fuyualice/Home_Temperature_Monitor/Hardware/M1A4/Preview/PCB.pdf

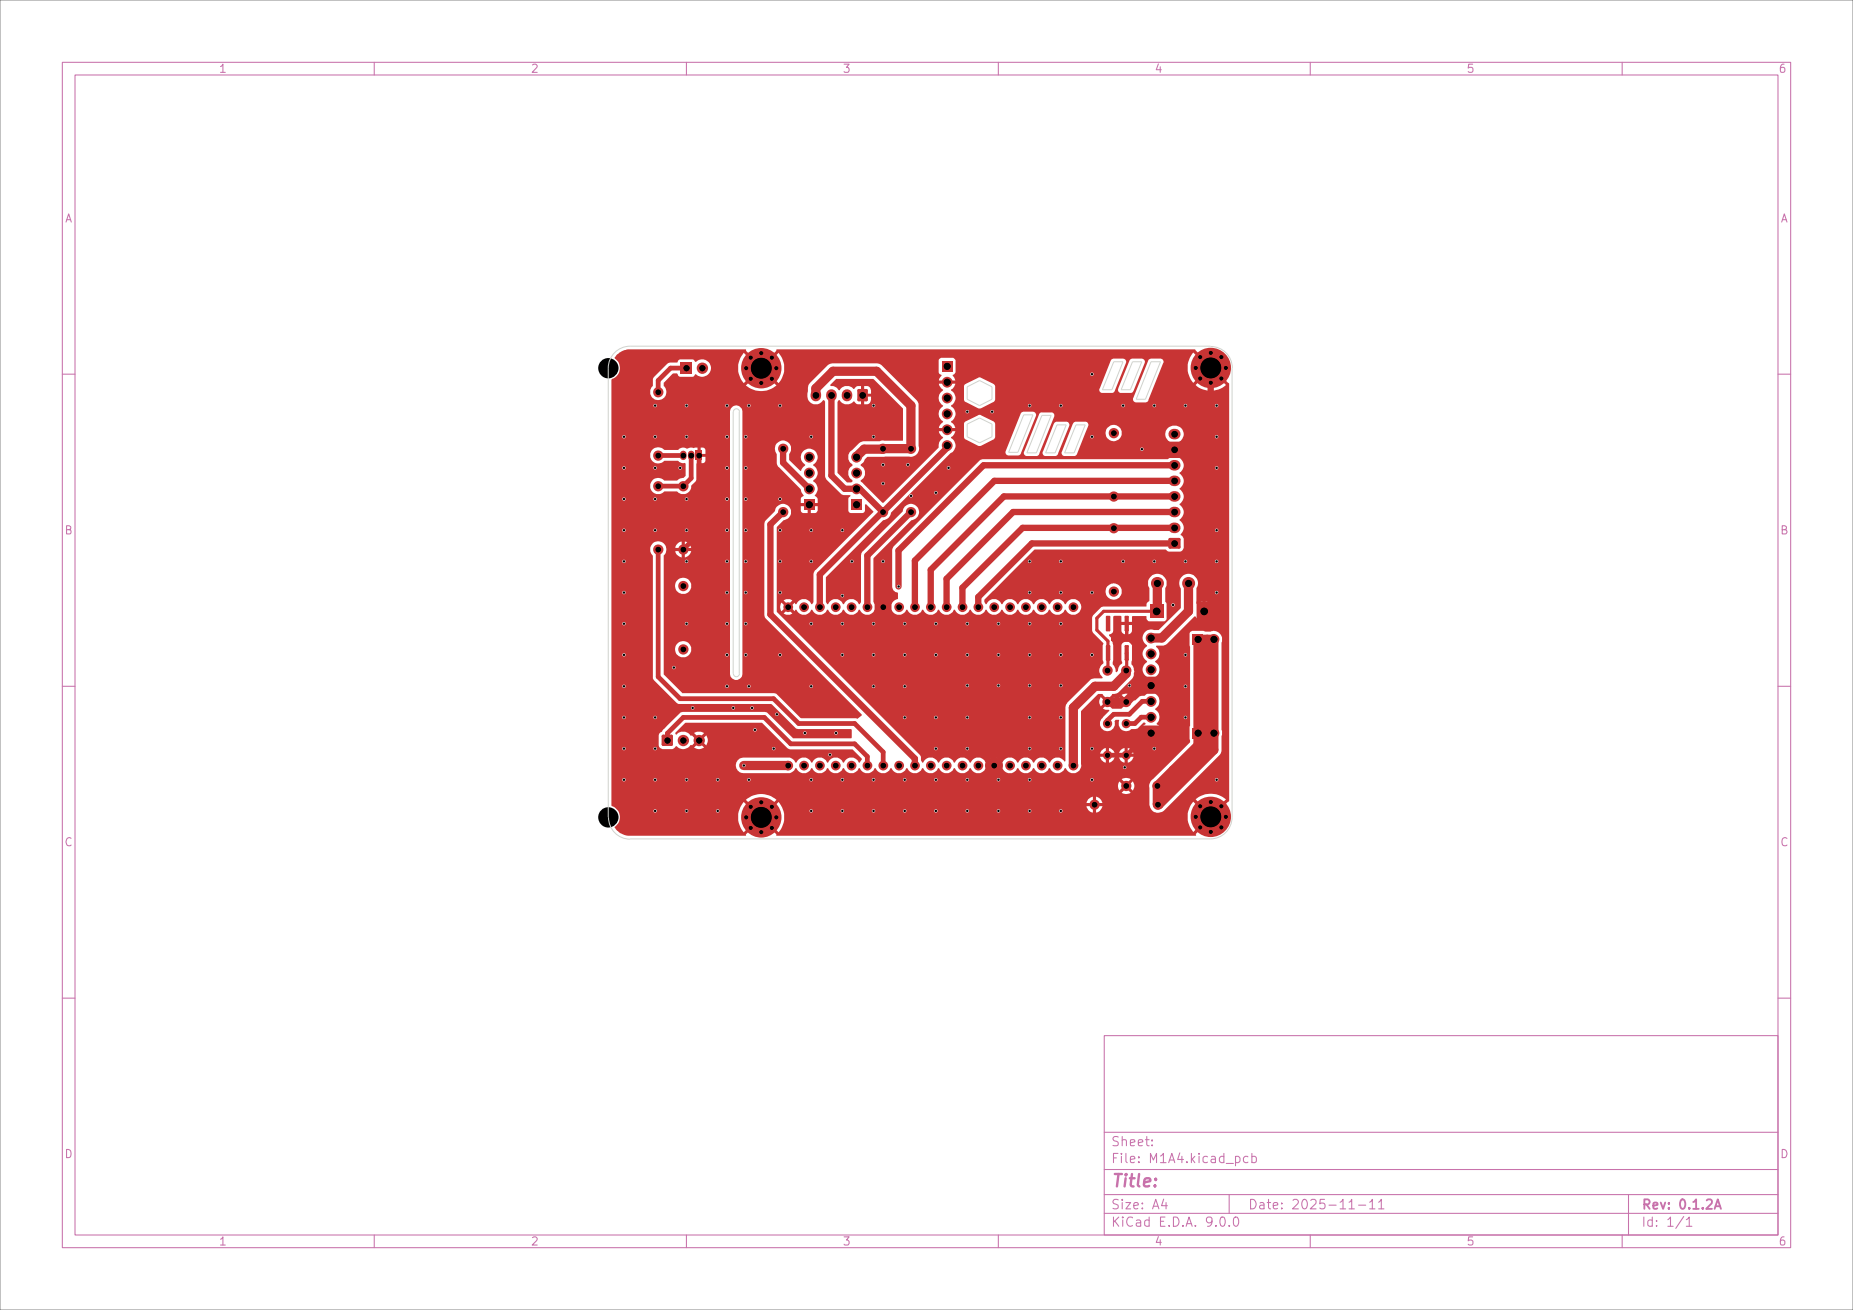
[picture p1: page 1]

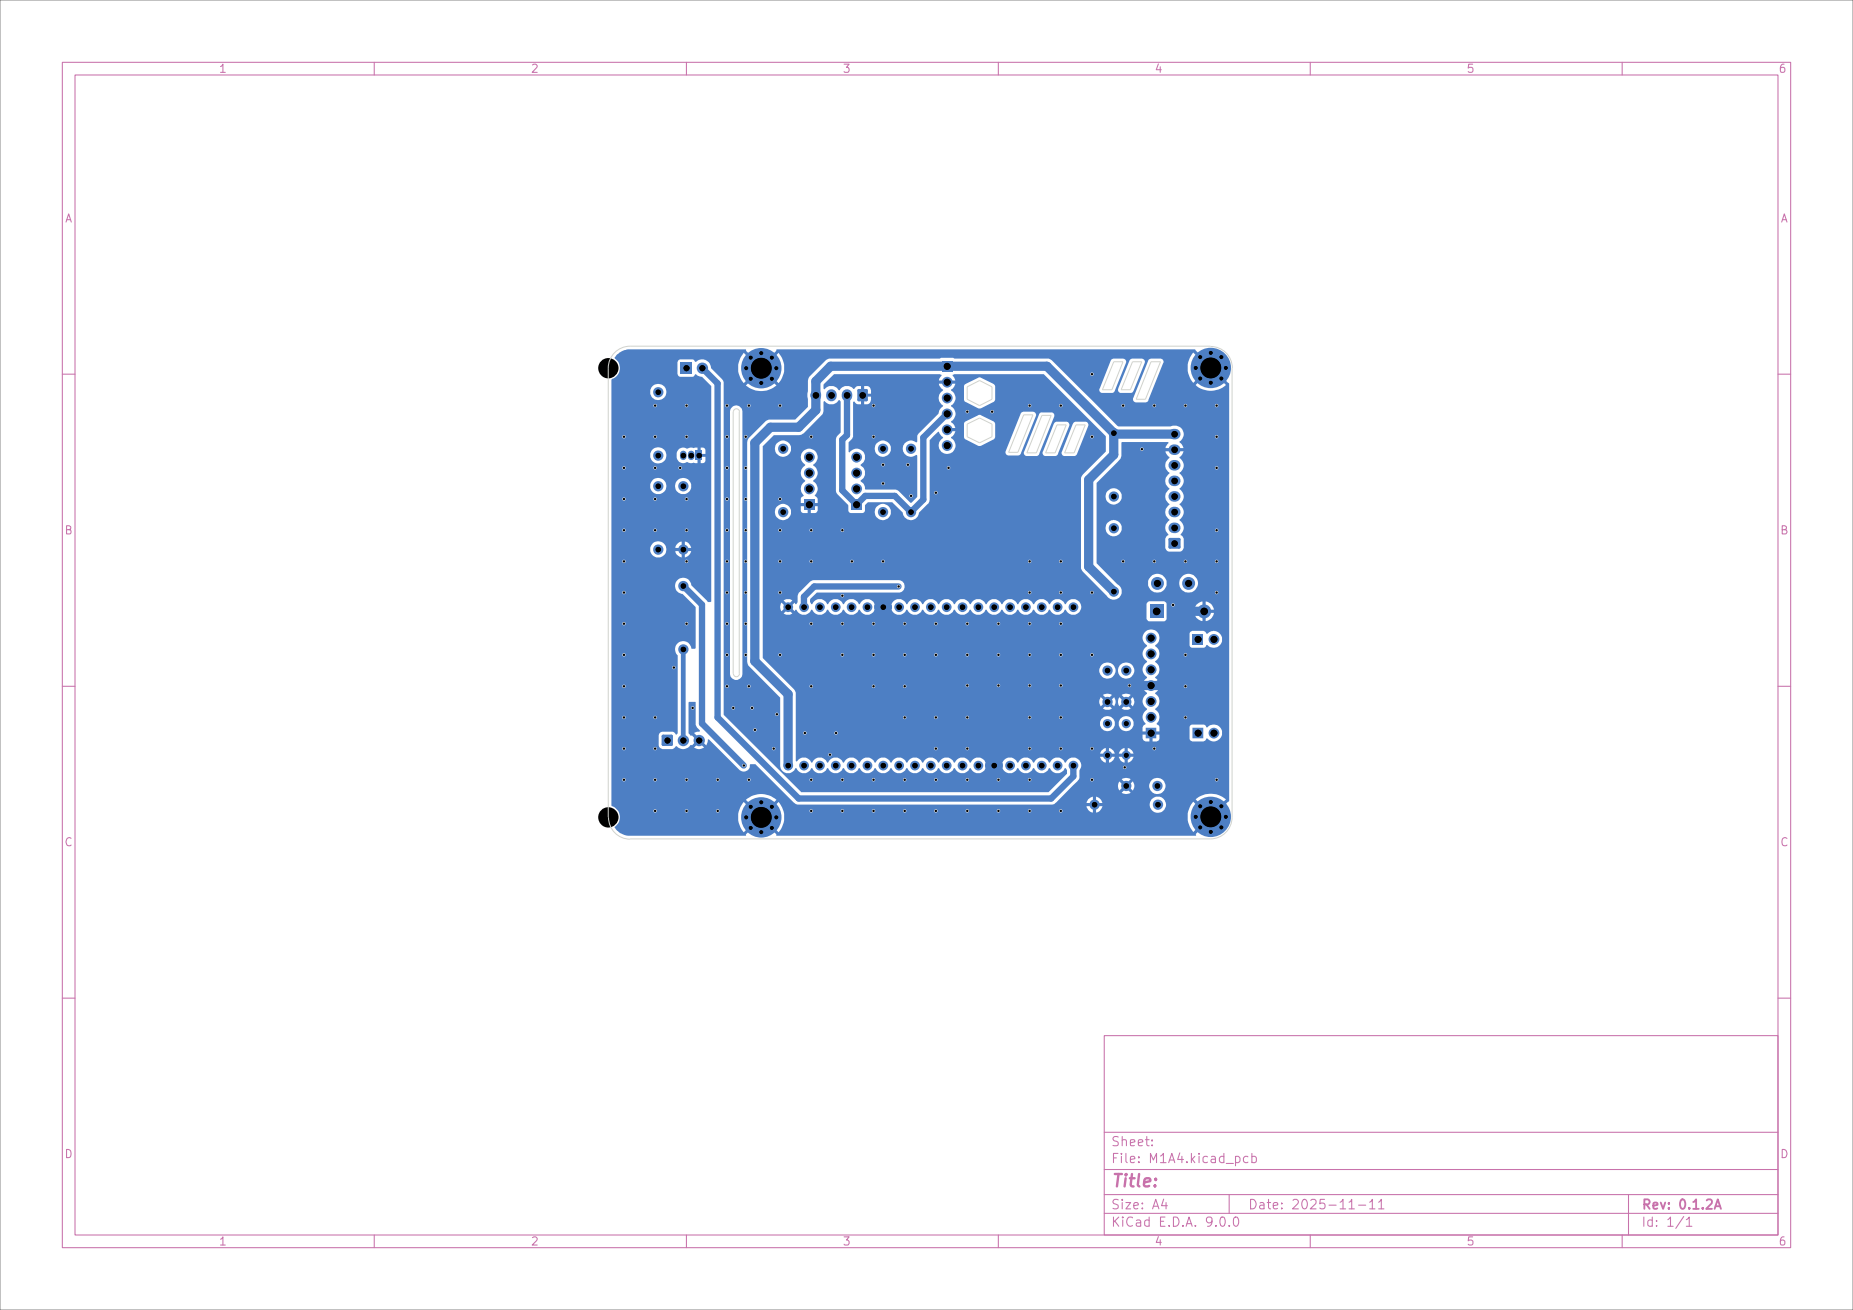
[picture p2: page 2]

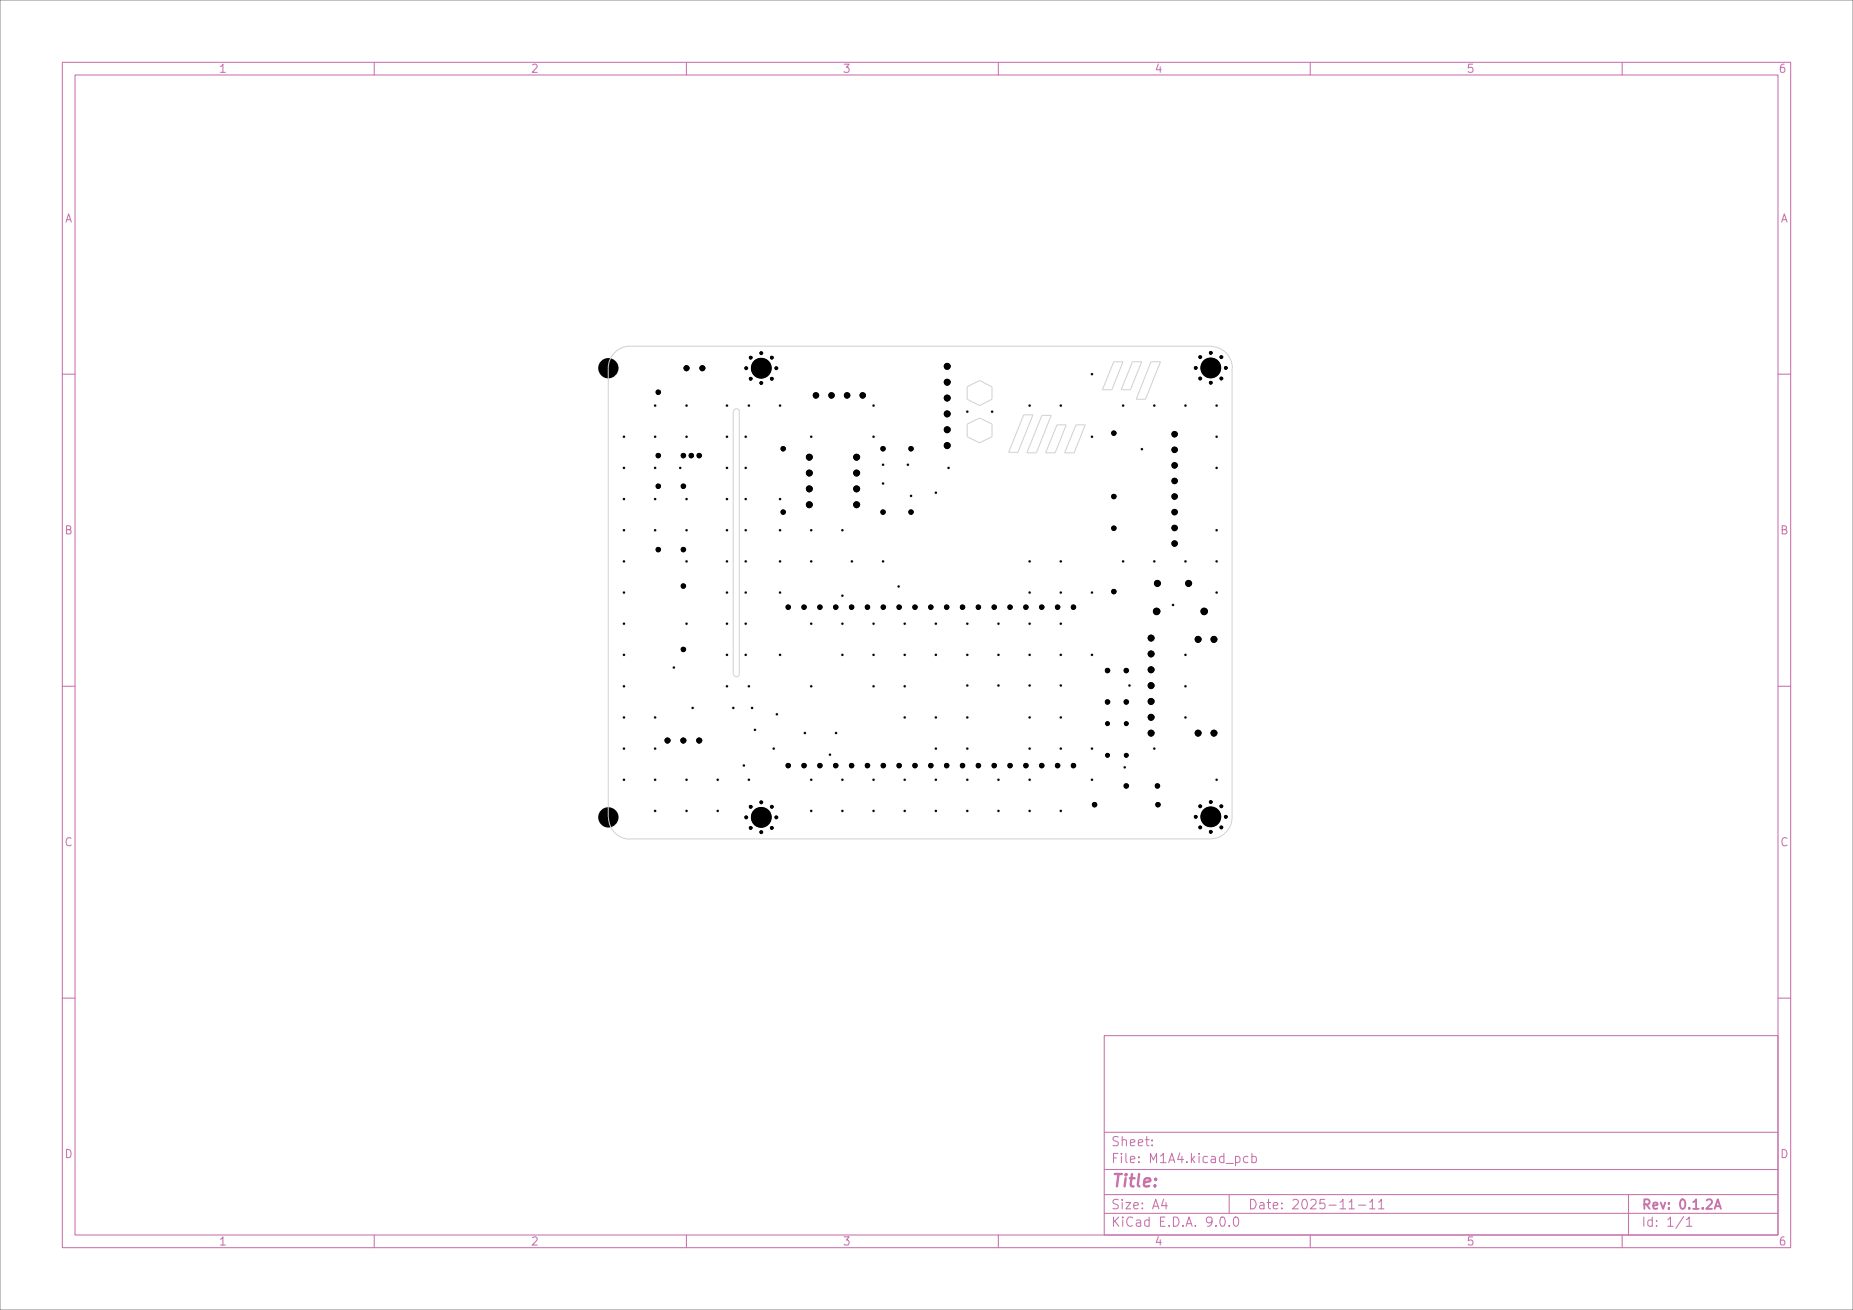
[picture p3: page 3]

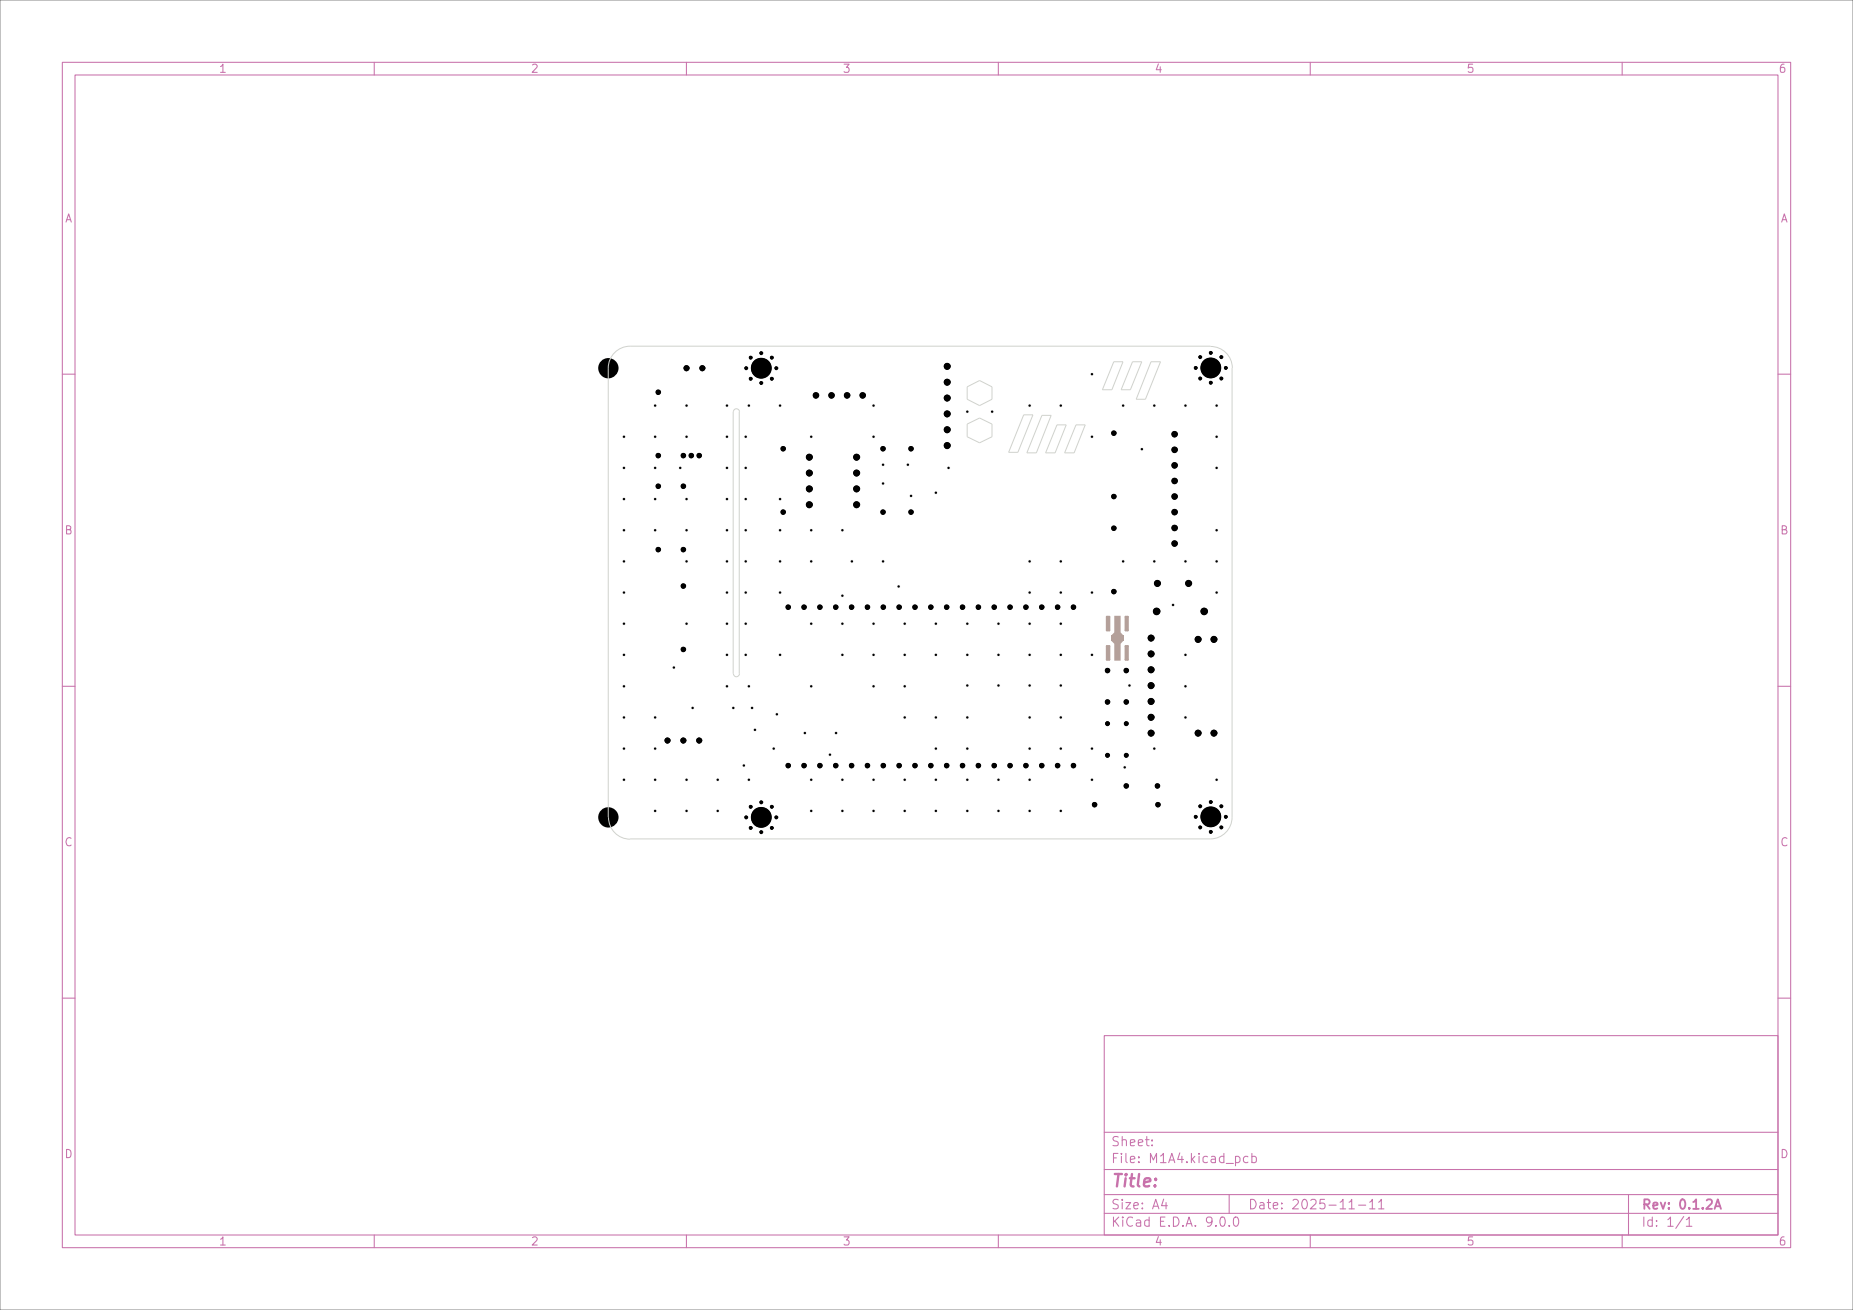
[picture p4: page 5]

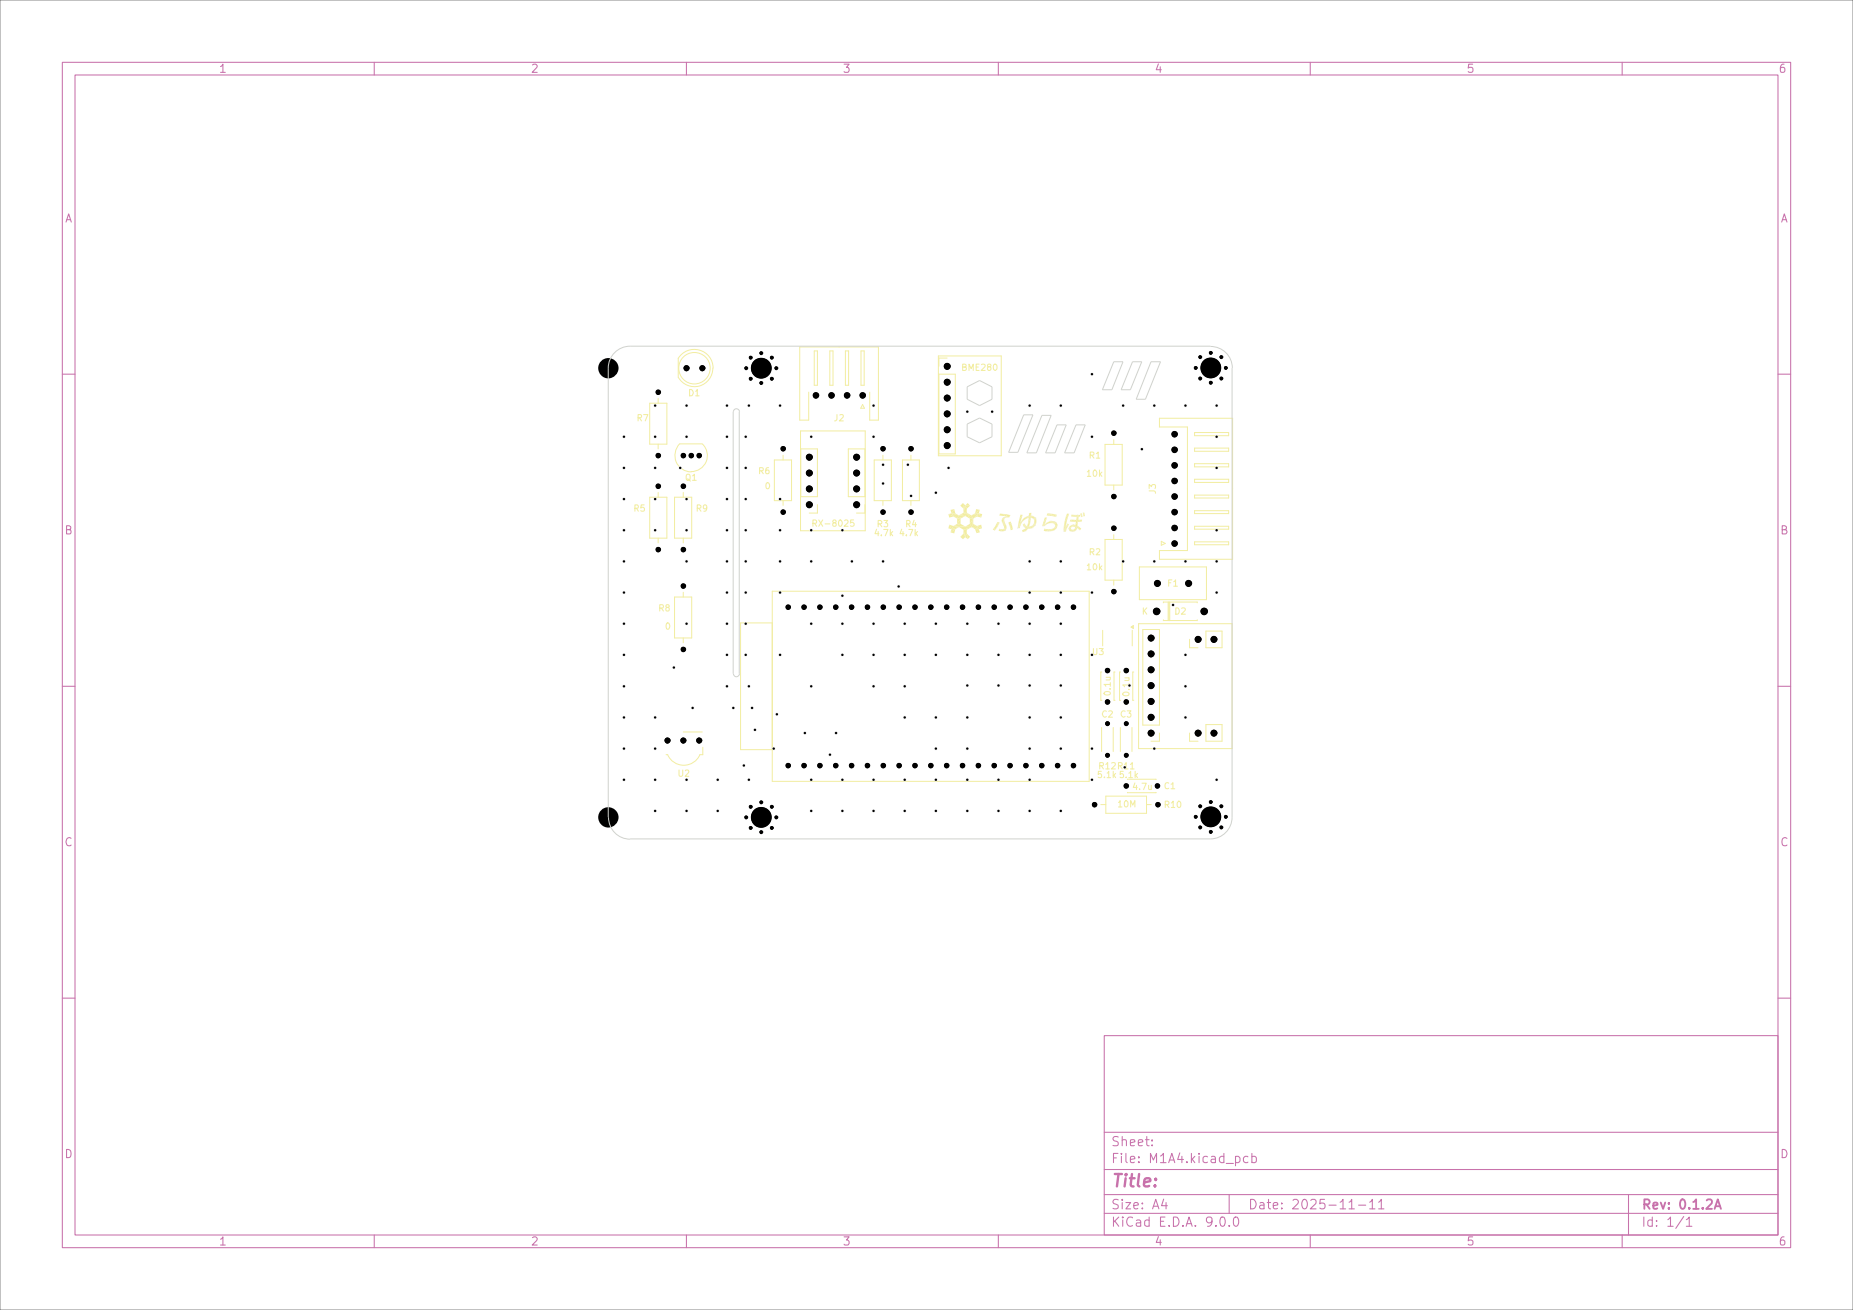
[picture p5: page 7]

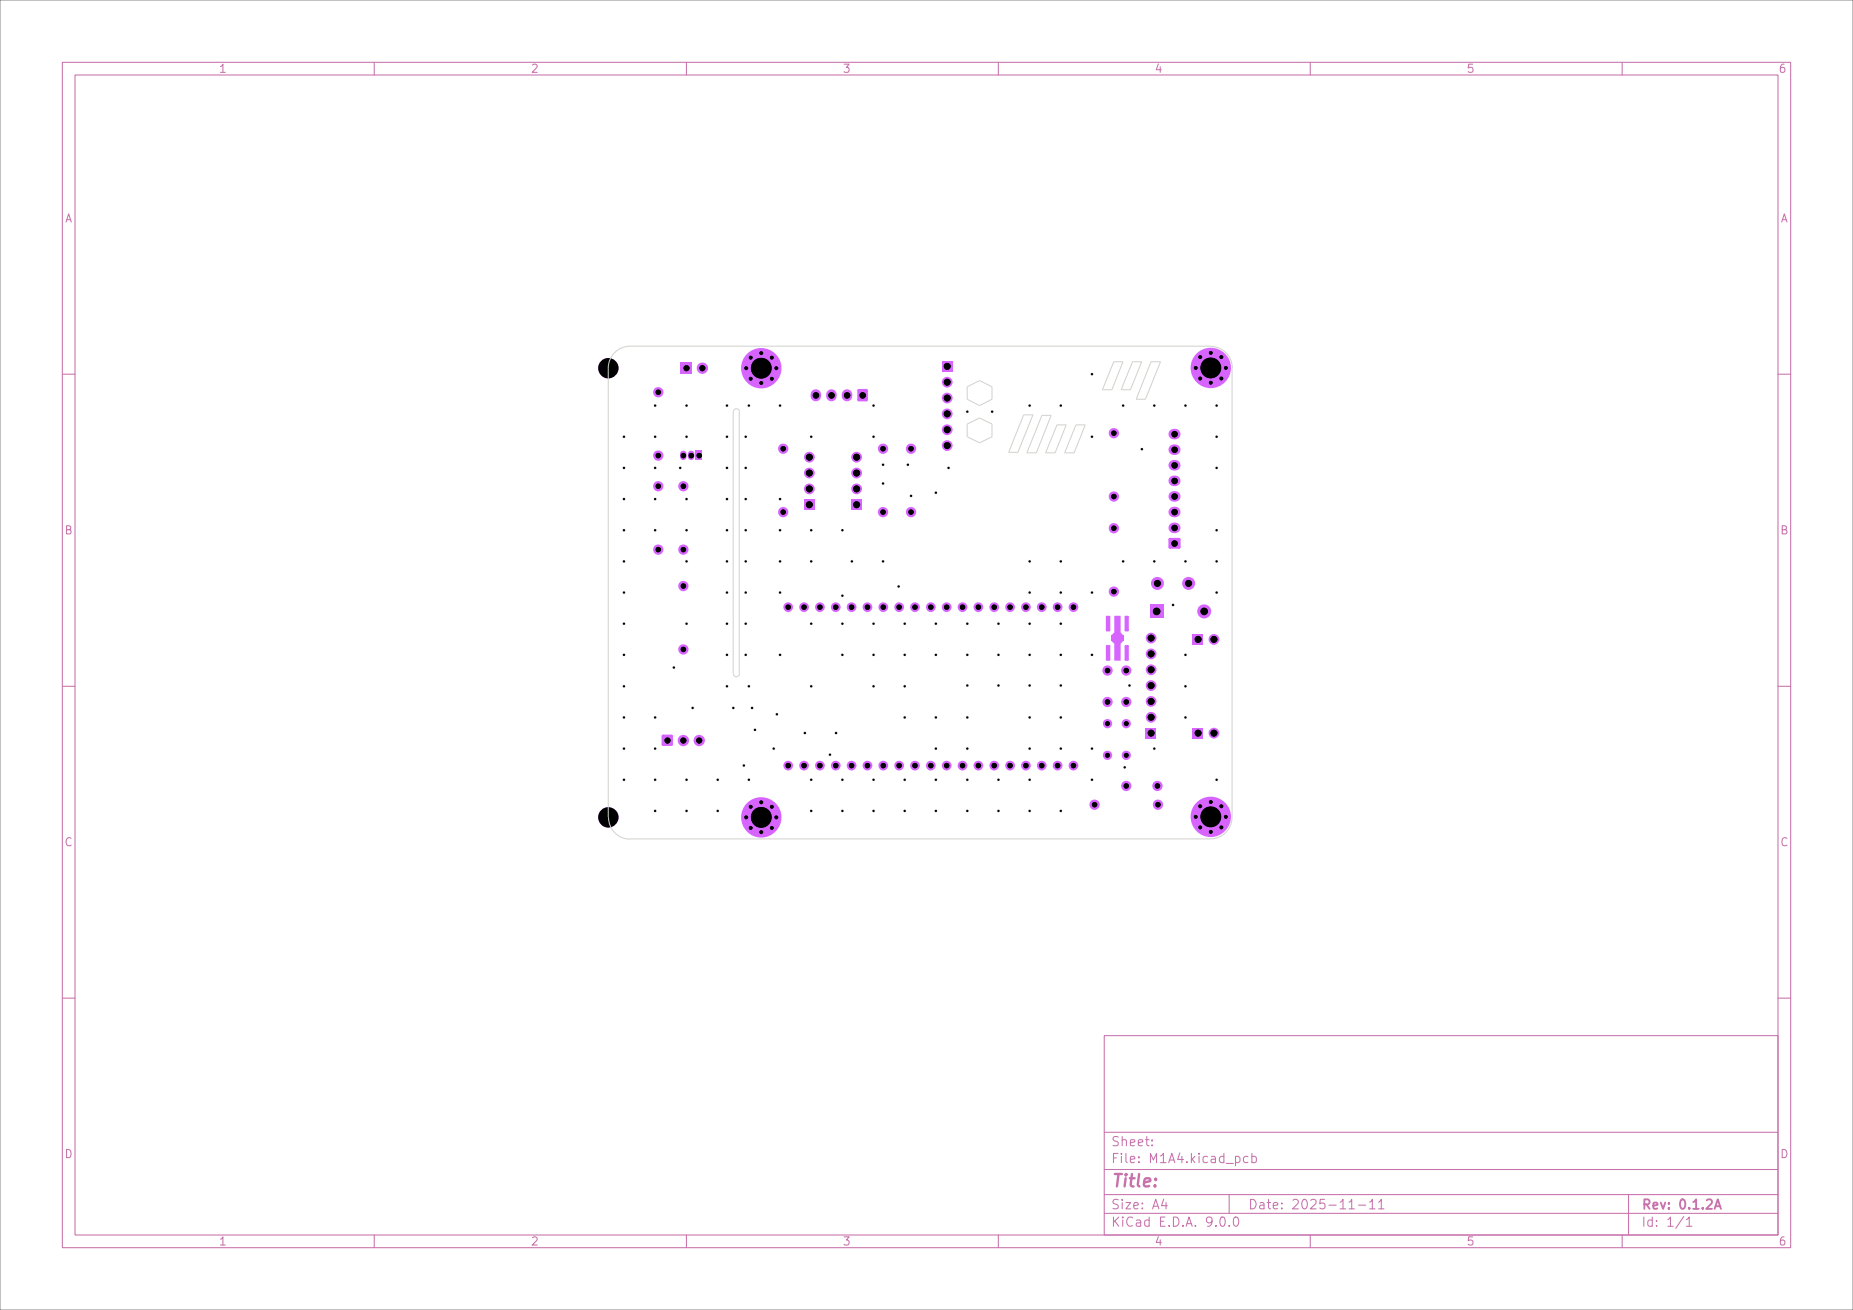
[picture p6: page 9]

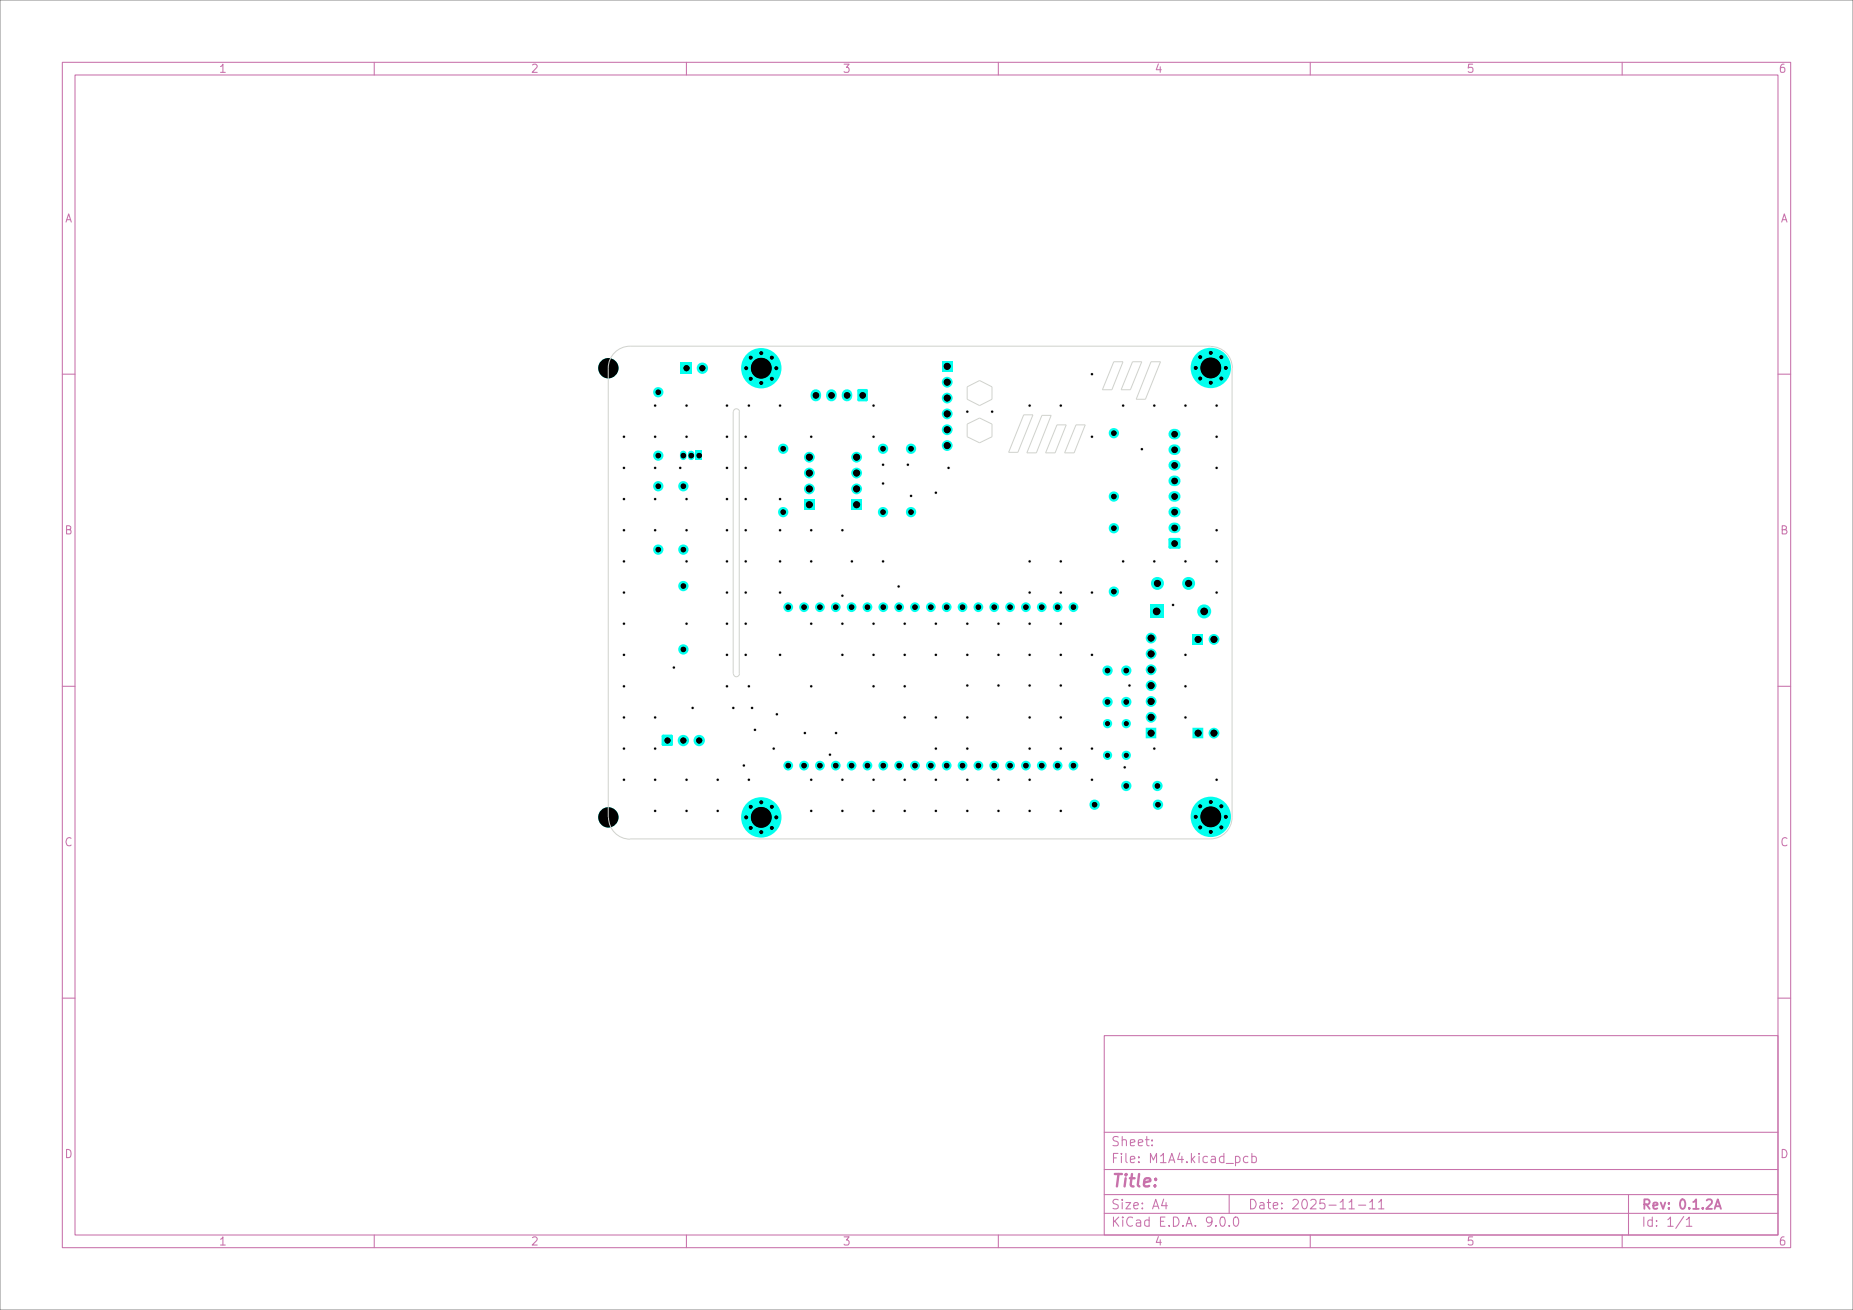
[picture p7: page 10]
