fuyualice/Home_Temperature_Monitor/Hardware/M1A4/Preview/Schematic.pdf

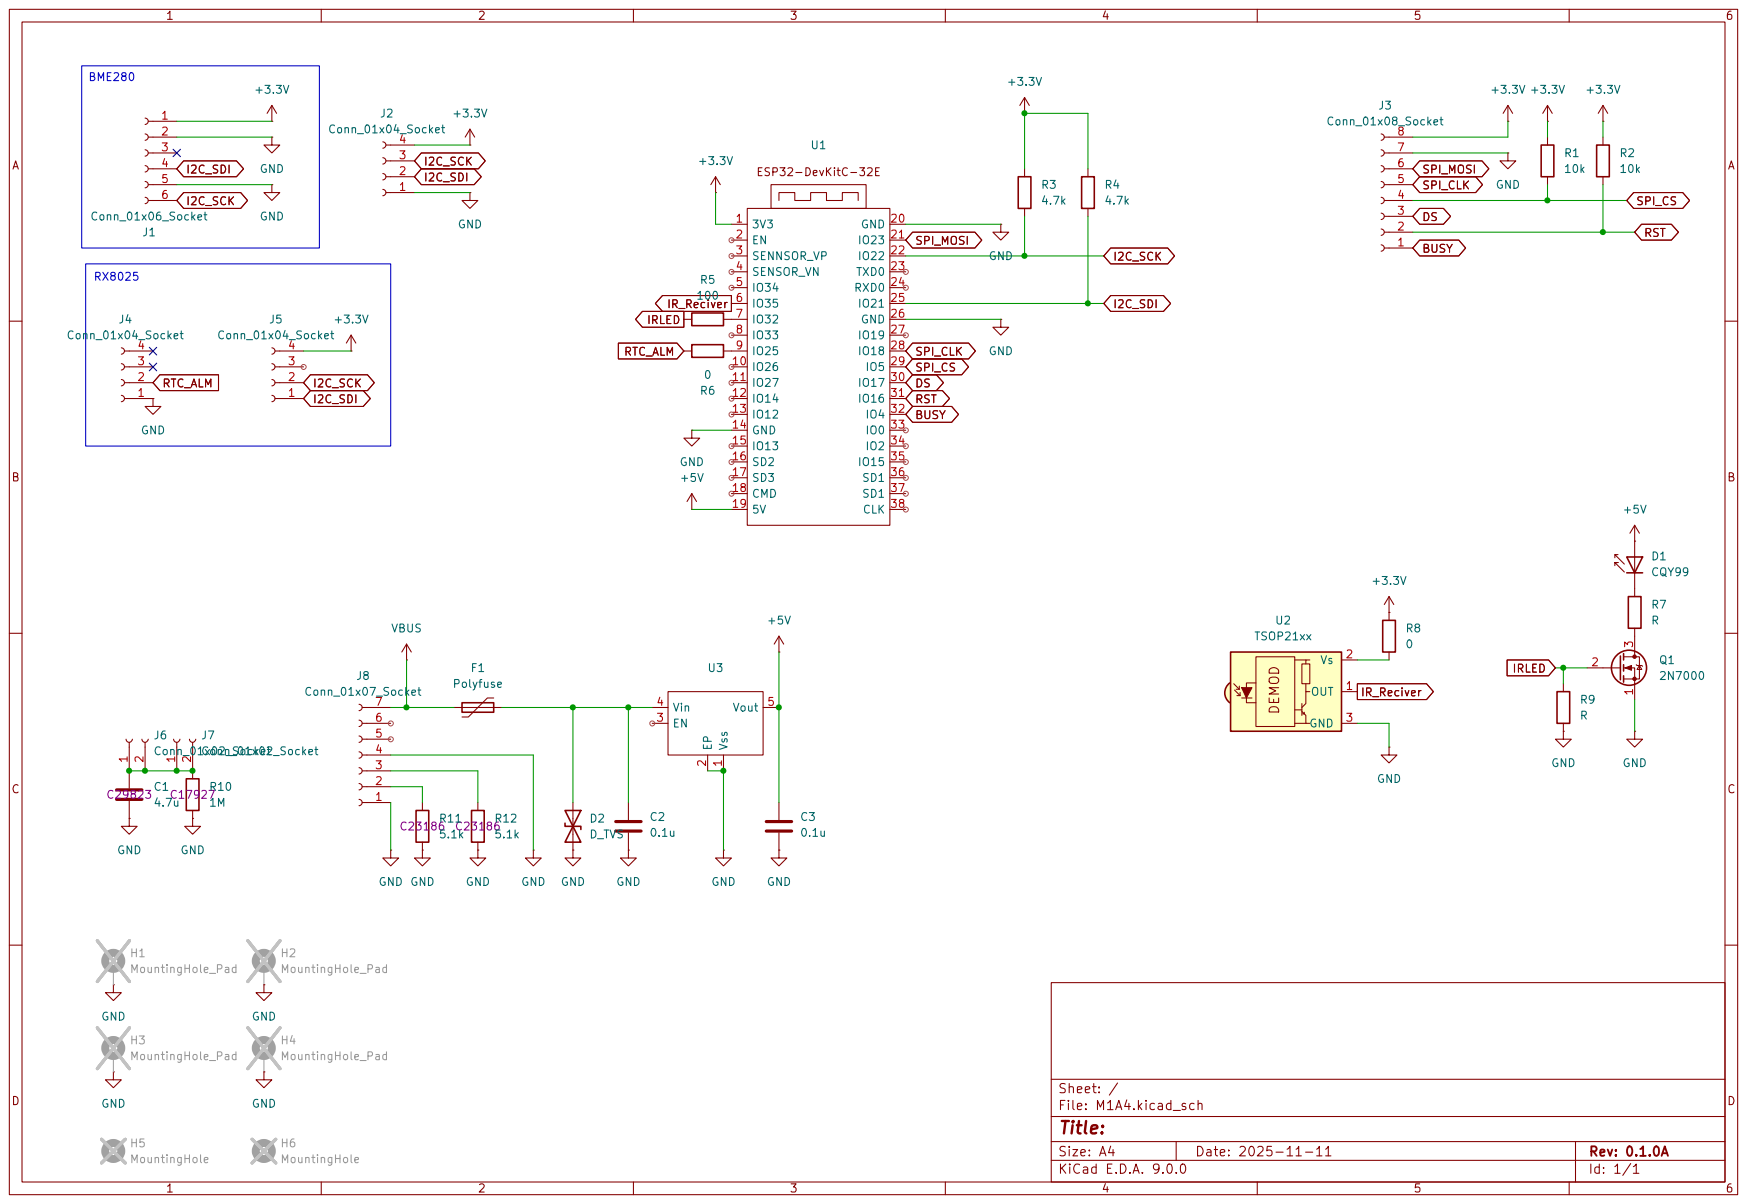
[picture p8: page 1]
