fuyualice/Home_Temperature_Monitor/Hardware/M1A4/M1A4.kicad_pcb

## KiCad design Hardware/M1A4/M1A4.kicad_pcb (2025-11-25)

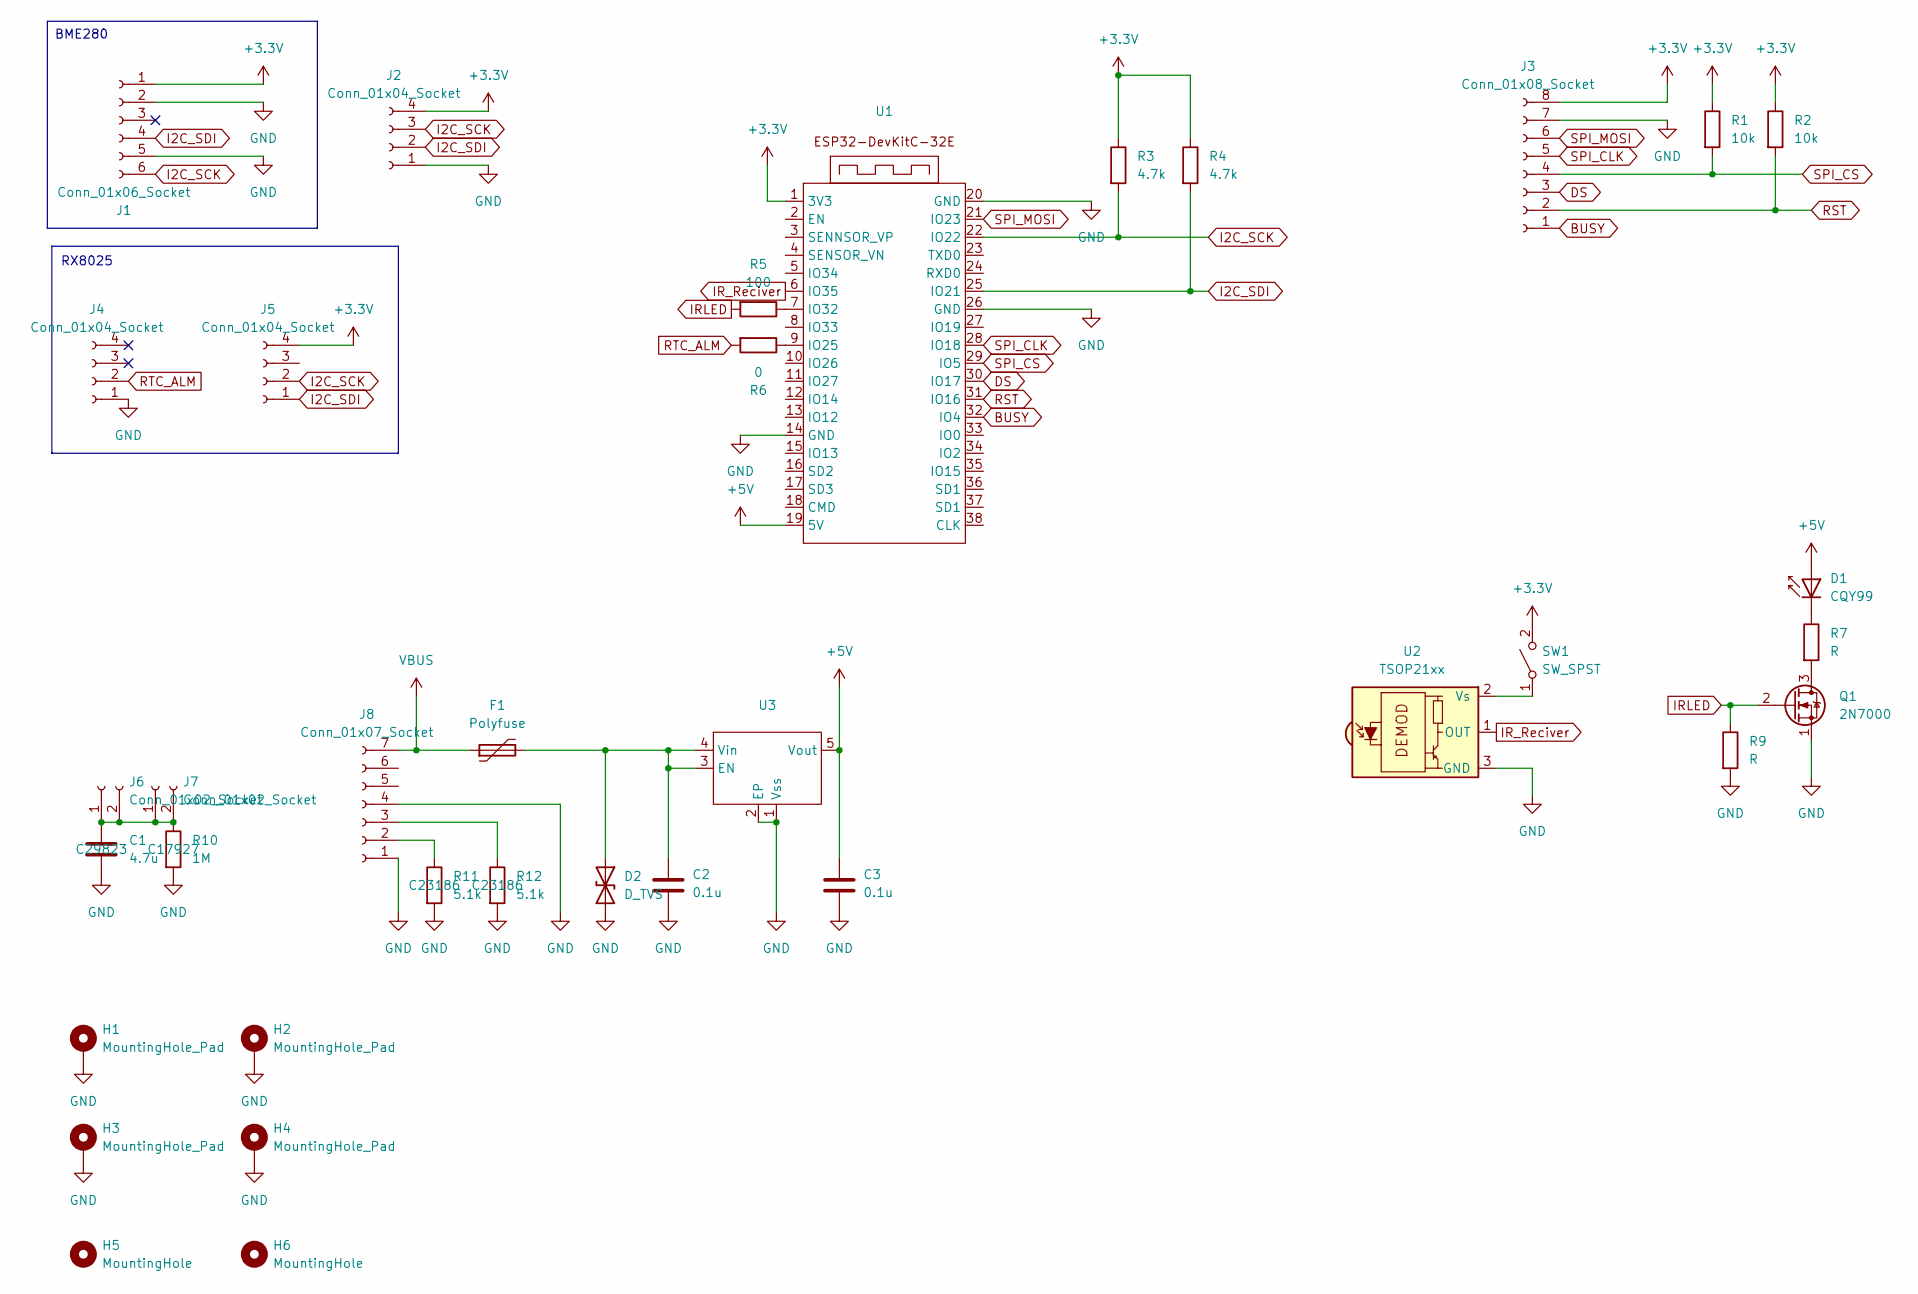
[picture p9: schematic M1A4.kicad_sch]

Parts:
C1: 4.7u; C_Disc_D4.3mm_W1.9mm_P5.00mm; LCSC C29823
C2, C3: 0.1u; C_Disc_D4.3mm_W1.9mm_P5.00mm
D1: CQY99; LED_D5.0mm_IRGrey
D2: D_TVS; D_DO-41_SOD81_P7.62mm_Horizontal
F1: Polyfuse; C_Disc_D10.5mm_W5.0mm_P5.00mm
H1, H2, H3, H4: MountingHole_Pad; MountingHole_3.2mm_M3_Pad_Via
H5, H6: MountingHole; MountingHole_3.2mm_M3
J1: Conn_01x06_Socket; PinHeader_1x06_P2.54mm_Vertical
J2: Conn_01x04_Socket; JST_XH_S4B-XH-A-1_1x04_P2.50mm_Horizontal
J3: Conn_01x08_Socket; JST_XH_S8B-XH-A_1x08_P2.50mm_Horizontal
J4, J5: Conn_01x04_Socket; PinHeader_1x04_P2.54mm_Vertical
J6, J7: Conn_01x02_Socket; PinHeader_1x02_P2.54mm_Vertical
J8: Conn_01x07_Socket; PinHeader_1x07_P2.54mm_Vertical
Q1: 2N7000; TO-92_Inline
R1, R2: 10k; R_Axial_DIN0207_L6.3mm_D2.5mm_P10.16mm_Horizontal
R3, R4: 4.7k; R_Axial_DIN0207_L6.3mm_D2.5mm_P10.16mm_Horizontal
R5: 100; R_Axial_DIN0207_L6.3mm_D2.5mm_P10.16mm_Horizontal
R6: 0; R_Axial_DIN0207_L6.3mm_D2.5mm_P10.16mm_Horizontal
R7, R9: R; R_Axial_DIN0207_L6.3mm_D2.5mm_P10.16mm_Horizontal
R10: 1M; R_Axial_DIN0207_L6.3mm_D2.5mm_P10.16mm_Horizontal; LCSC C17927
R11, R12: 5.1k; R_Axial_DIN0204_L3.6mm_D1.6mm_P5.08mm_Horizontal; LCSC C23186
SW1: SW_SPST
U1: esp32-devkit
U2: TSOP21xx; Vishay_MOLD-3Pin
U3: SOT-89-5_Handsoldering

Connections:
+3.3V: J1.1, J2.4, J3.8, J5.4, R1.1, R2.1, R3.1, R4.1, SW1.2 (B), U1.1 (3V3)
+5V: C3.1, D1.2 (A), U1.19 (5V), U3.5 (Vout)
BUSY: J3.1, U1.32 (IO4)
DS: J3.3, U1.30 (IO17)
GND: C1.2, C2.2, C3.2, D2.2 (A2), H1.1, H2.1, H3.1, H4.1, J1.2, J1.5, J2.1, J3.7, J4.1, J8.1, J8.4, Q1.1 (S), R9.2, R10.2, R11.2, R12.2, U1.14 (GND), U1.20 (GND), U1.26 (GND), U2.3 (GND), U3.1 (Vss), U3.2 (EP)
I2C_SCK: J1.6, J2.3, J5.2, R3.2, U1.22 (IO22)
I2C_SDI: J1.4, J2.2, J5.1, R4.2, U1.25 (IO21)
IRLED: Q1.2 (G), R5.2, R9.1
IR_Reciver: U1.6 (IO35), U2.1 (OUT)
unnamed: D1.1 (K), R7.1
unnamed: C2.1, D2.1 (A1), F1.2, U3.3 (EN), U3.4 (Vin)
unnamed: C1.1, J6.1, J6.2, J7.1, J7.2, R10.1
unnamed: J8.2, R11.1
unnamed: J8.3, R12.1
unnamed: Q1.3 (D), R7.2
unnamed: SW1.1 (A), U2.2 (Vs)
unnamed: R6.1, U1.9 (IO25)
unnamed: R5.1, U1.7 (IO32)
RST: J3.2, R2.2, U1.31 (IO16)
RTC_ALM: J4.2, R6.2
SPI_CLK: J3.5, U1.28 (IO18)
SPI_CS: J3.4, R1.2, U1.29 (IO5)
SPI_MOSI: J3.6, U1.21 (IO23)
VBUS: F1.1, J8.7

Notes on the sheet:
RX8025
BME280

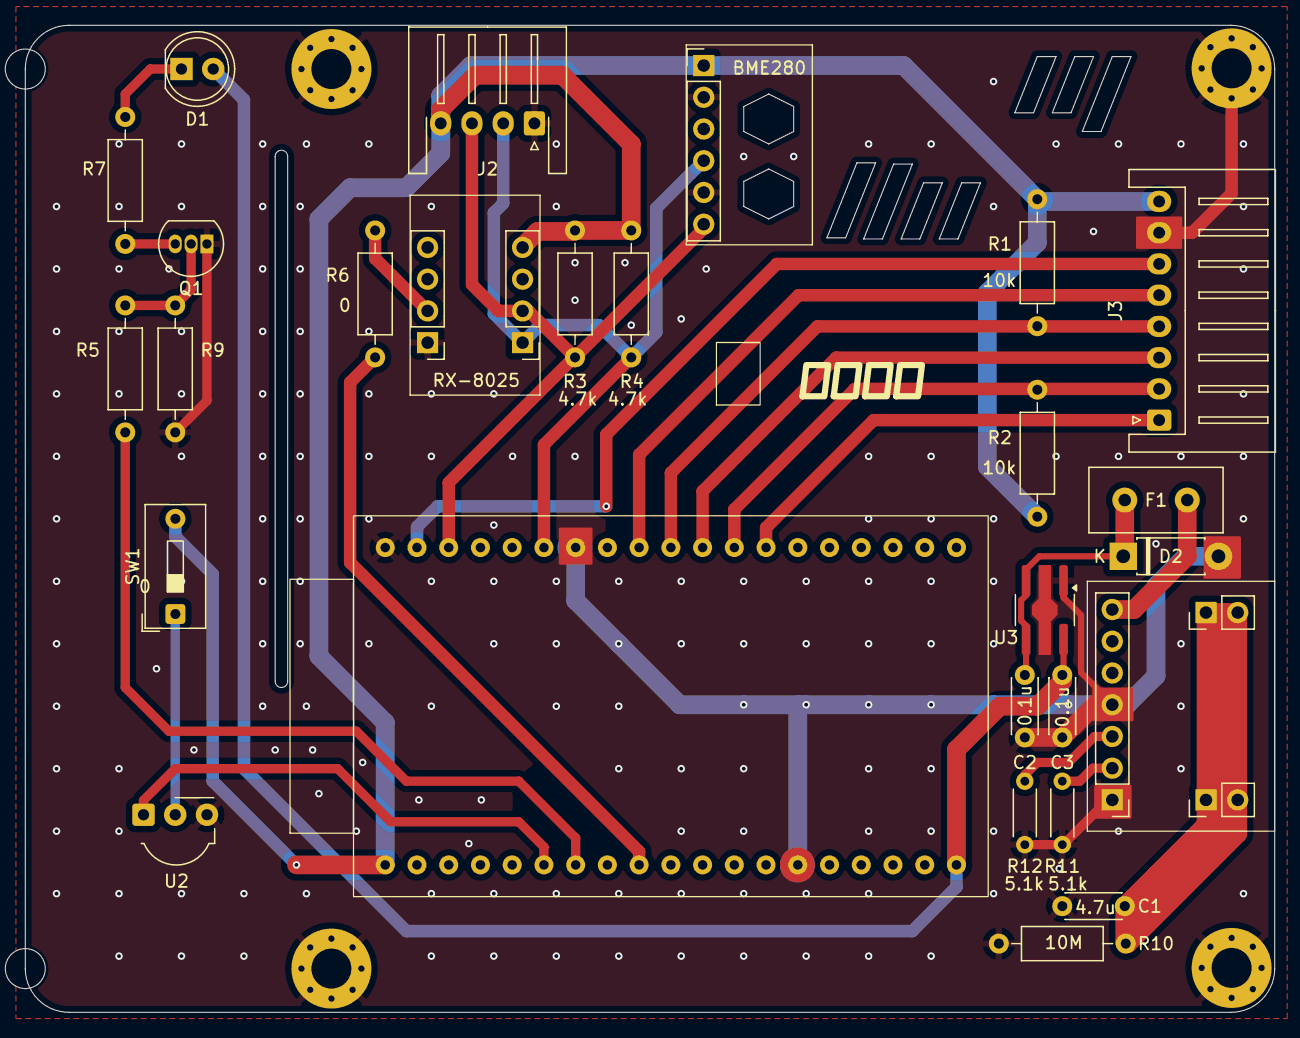
[picture p10: board M1A4.kicad_pcb from above]

Board: 2 copper layers, 100.0 x 79.0 mm, 36 parts (0 on the bottom side), 24 nets.
