fuyualice/Home_Temperature_Monitor/(commit log)

2025-12-08 Fix: Resolve e-paper ghosting and position offset.
    [RX8025.cpp, main.cpp]
2025-12-11 Ignore assembly files.
    [M1A4-B_Cu.gbr, M1A4-B_Mask.gbr, M1A4-B_Paste.gbr, M1A4-B_Silkscreen.gbr, M1A4-Edge_Cuts.gbr, M1A4-F_Cu.gbr, M1A4-F_Mask.gbr, M1A4-F_Paste.gbr]
2025-12-12 Fix: Resolve time drift issue after NTP sync.
    [main.cpp]
